boyerd/sprocket_clock/README.md

Sprocket Clock

==============

A gear clock build from a driven spur gear and a large inner gear that rides on it.  The spur gear indicates minutes and the large inner gear indicates the hour.
