boyerd/sprocket_clock/hardware/sprocket_clock.pdf

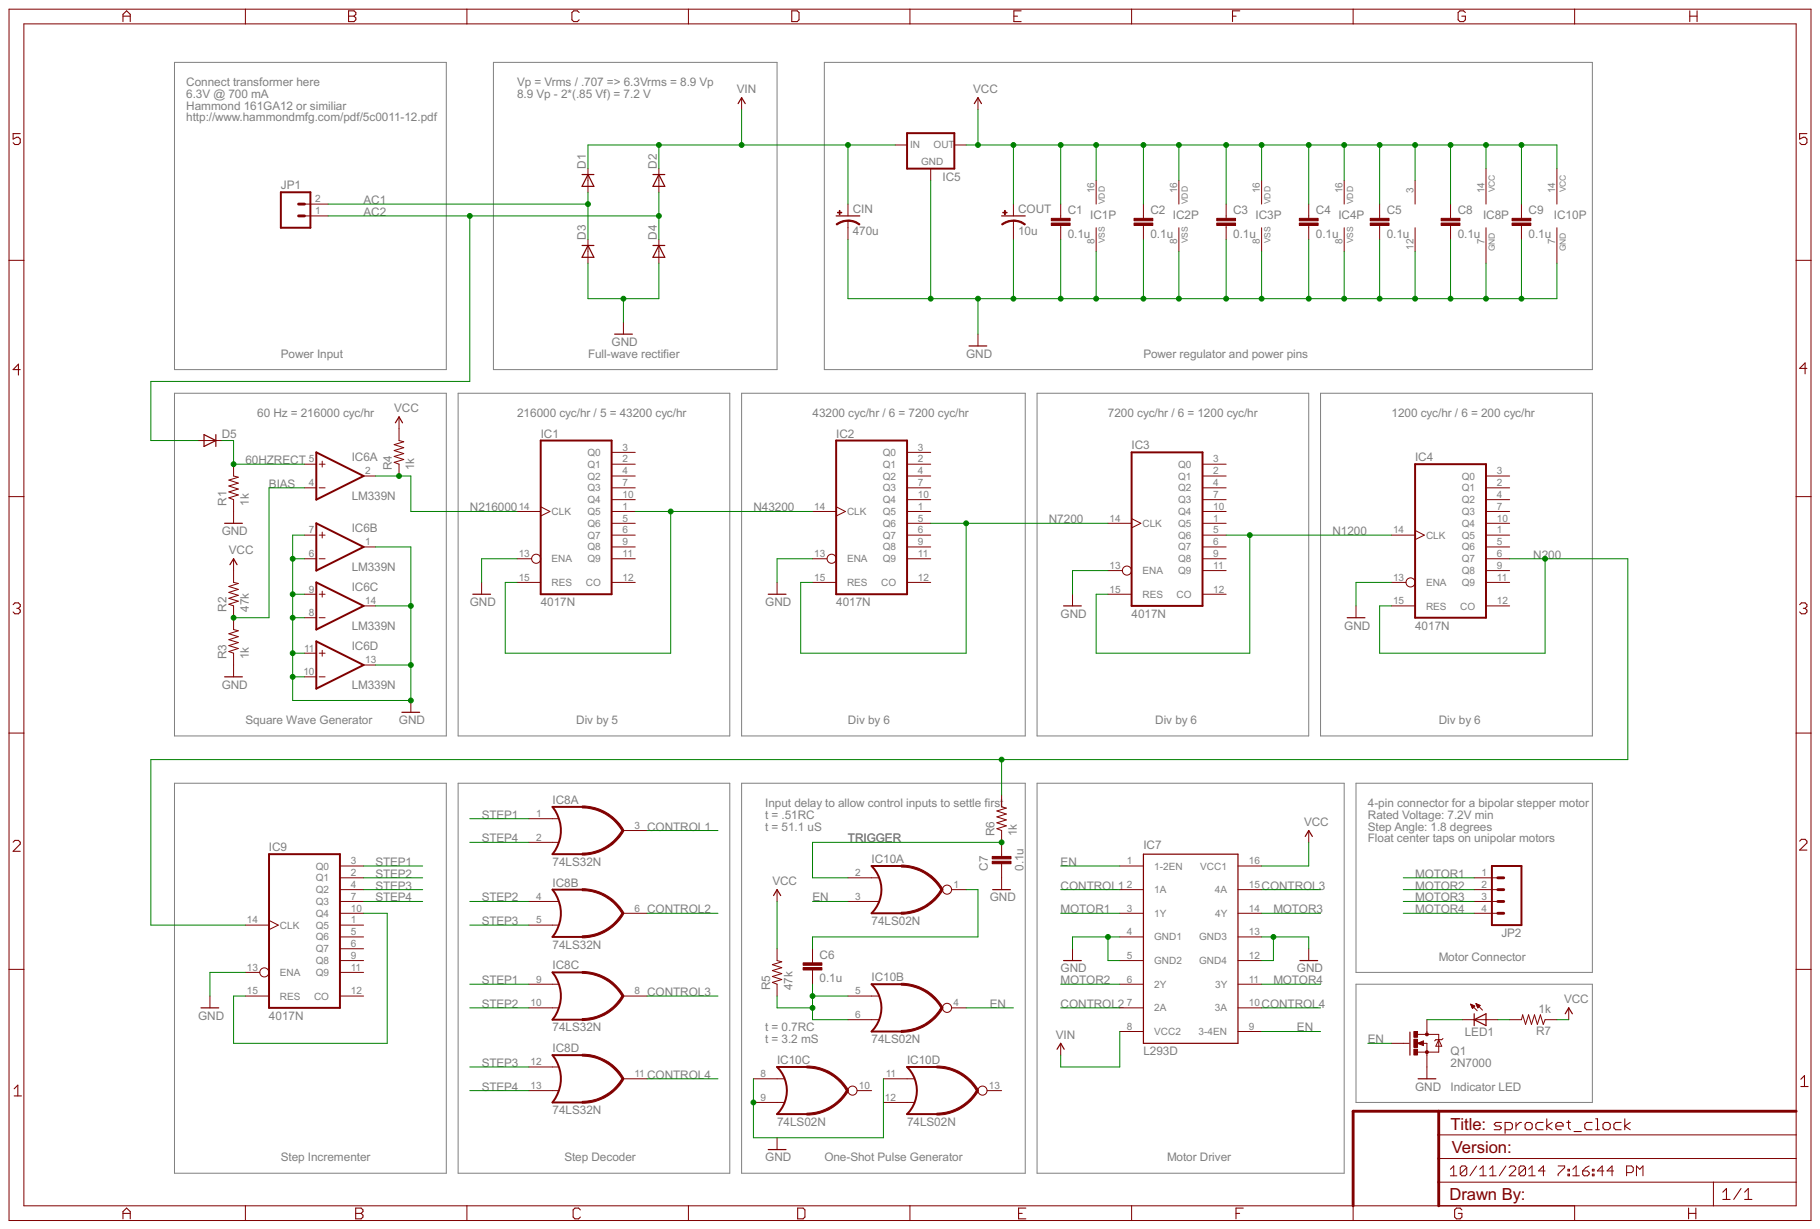
[picture p1: page 1]

http://www.hammondmfg.com/pdf/5c0011-12.pdf Connect transformer here

Input delay to allow control inputs to settle first

4-pin connector for a bipolar stepper motor Step Angle: 1.8 degrees Float center taps on unipolar motors Rated Voltage: 7.2V min

Drawn By: Title: Version:
