boyerd/sprocket_clock/hardware/sprocket_clock.brd

## EAGLE design hardware/sprocket_clock.brd (2014-10-12)

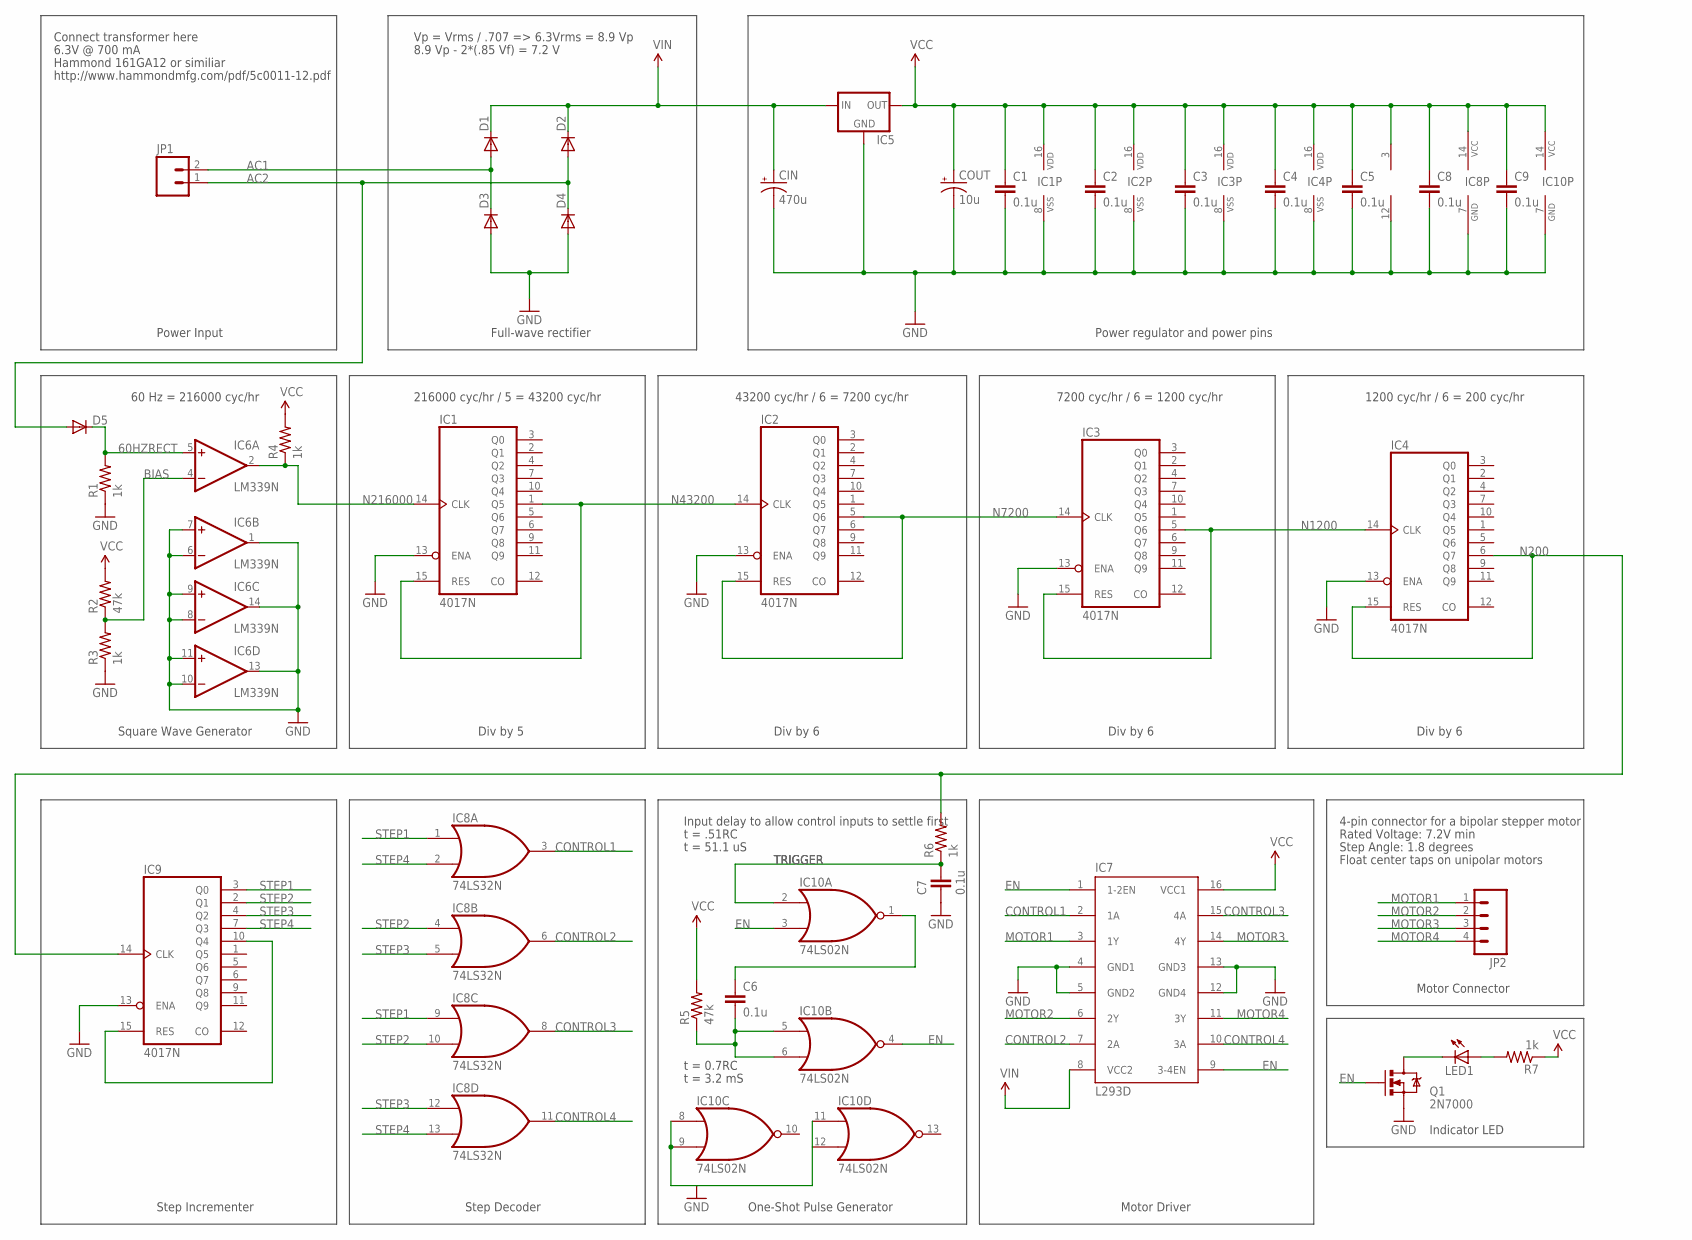
[picture p2: schematic sprocket_clock.sch]

Parts:
C1, C2, C3, C4, C5, C6, C7, C8, C9: 0.1u; CAP-PTH-5MM
CIN: 470u; CPOL-RADIAL-1000UF-63V
COUT: 10u; CPOL-RADIAL-10UF-25V
D1, D2, D3, D4, D5: DIODEPTH; DIODE-1N4001
IC1, IC2, IC3, IC4, IC9: 4017N; DIL16
IC5: V_REG_78XXTO-92; TO-92
IC6: LM339N; DIL14
IC7: L293D; DIL16
IC8: 74LS32N; DIL14
IC10: 74LS02N; DIL14
JP1: M023.5MM-NO_SILK; SCREWTERMINAL-3.5MM-2-NS
JP2: M04SCREW; SCREWTERMINAL-3.5MM-4
LED1: LED5MM
Q1: 2N7000; TO-92
R1, R3, R4, R6, R7: 1k; AXIAL-0.4
R2, R5: 47k; AXIAL-0.4

Connections:
60HZRECT: D5.C, IC6.5 (+IN), R1.P$2 (2)
AC1: D1.A, D3.C, JP1.2
AC2: D2.A, D4.C, D5.A, JP1.1
BIAS: IC6.4 (-IN), R2.P$1 (1), R3.P$2 (2)
CONTROL1: IC7.2 (1A), IC8.3 (O)
CONTROL2: IC7.7 (2A), IC8.6 (O)
CONTROL3: IC7.15 (4A), IC8.8 (O)
CONTROL4: IC7.10 (3A), IC8.11 (O)
EN: IC7.1 (1-2EN), IC7.9 (3-4EN), IC10.3 (I1), IC10.4 (O), Q1.2 (G)
GND: C1.2, C2.2, C3.2, C4.2, C5.2, C7.2, C8.2, C9.2, CIN.2 (-), COUT.2 (-), D3.A, D4.A, IC1.8 (VSS), IC1.13 (ENA), IC2.8 (VSS), IC3.8 (VSS), IC4.8 (VSS), IC5.1 (GND), IC6.1 (OUT), IC6.6 (-IN), IC6.7 (+IN), IC6.8 (-IN), IC6.9 (+IN), IC6.10 (-IN), IC6.11 (+IN), IC6.12 (GND), IC6.13 (OUT), IC6.14 (OUT), IC7.4 (GND1), IC7.5 (GND2), IC7.12 (GND4), IC7.13 (GND3), IC8.7 (GND), IC10.7 (GND), Q1.1 (S), R1.P$1 (1), R3.P$1 (1)
MOTOR1: IC7.3 (1Y), JP2.1
MOTOR2: IC7.6 (2Y), JP2.2
MOTOR3: IC7.14 (4Y), JP2.3
MOTOR4: IC7.11 (3Y), JP2.4
N200: IC4.6 (Q7), IC4.15 (RES), IC9.14 (CLK), R6.P$2 (2)
N1200: IC3.5 (Q6), IC3.15 (RES), IC4.14 (CLK)
N7200: IC2.5 (Q6), IC2.15 (RES), IC3.14 (CLK)
N43200: IC1.1 (Q5), IC1.15 (RES), IC2.14 (CLK)
N216000: IC1.14 (CLK), IC6.2 (OUT), R4.P$1 (1)
unnamed: LED1.A, R7.P$2 (2)
unnamed: IC9.10 (Q4), IC9.15 (RES)
unnamed: C6.1, IC10.1 (O)
unnamed: C6.2, IC10.5 (I0), IC10.6 (I1), R5.P$1 (1)
unnamed: LED1.K (C), Q1.3 (D)
unnamed: IC10.8 (I0), IC10.9 (I1), IC10.11 (I0)
STEP1: IC8.1 (I0), IC8.9 (I0), IC9.3 (Q0)
STEP2: IC8.4 (I0), IC8.10 (I1), IC9.2 (Q1)
STEP3: IC8.5 (I1), IC8.12 (I0), IC9.4 (Q2)
STEP4: IC8.2 (I1), IC8.13 (I1), IC9.7 (Q3)
TRIGGER: C7.1, IC10.2 (I0), R6.P$1 (1)
VCC: C1.1, C2.1, C3.1, C4.1, C5.1, C8.1, COUT.1 (+), IC1.16 (VDD), IC2.16 (VDD), IC3.16 (VDD), IC4.16 (VDD), IC5.3 (OUT), IC6.3 (V+), IC7.16 (VCC1), IC8.14 (VCC), IC10.14 (VCC), R2.P$2 (2), R4.P$2 (2), R5.P$2 (2), R7.P$1 (1)
VDD: IC9.16 (VDD)
VIN: CIN.1 (+), D1.C, D2.C, IC5.2 (IN), IC7.8 (VCC2)
VSS: IC9.8 (VSS)

Notes on the sheet:
Div by 5
Div by 6
http://www.hammondmfg.com/pdf/5c0011-12.pdf
Connect transformer here
6.3V @ 700 mA
Hammond 161GA12 or similiar
Vp = Vrms / .707 => 6.3Vrms = 8.9 Vp
8.9 Vp - 2*(.85 Vf) = 7.2 V
Power Input
Full-wave rectifier
Power regulator and power pins
Square Wave Generator
60 Hz = 216000 cyc/hr
216000 cyc/hr / 5 = 43200 cyc/hr
43200 cyc/hr / 6 = 7200 cyc/hr
7200 cyc/hr / 6 = 1200 cyc/hr
1200 cyc/hr / 6 = 200 cyc/hr
Step Incrementer
Step Decoder
One-Shot Pulse Generator
Motor Driver
Motor Connector
4-pin connector for a bipolar stepper motor
Step Angle: 1.8 degrees
Float center taps on unipolar motors
Rated Voltage: 7.2V min
t = 0.7RC
t = .51RC
t = 51.1 uS
Input delay to allow control inputs to settle first
Indicator LED
t = 3.2 mS

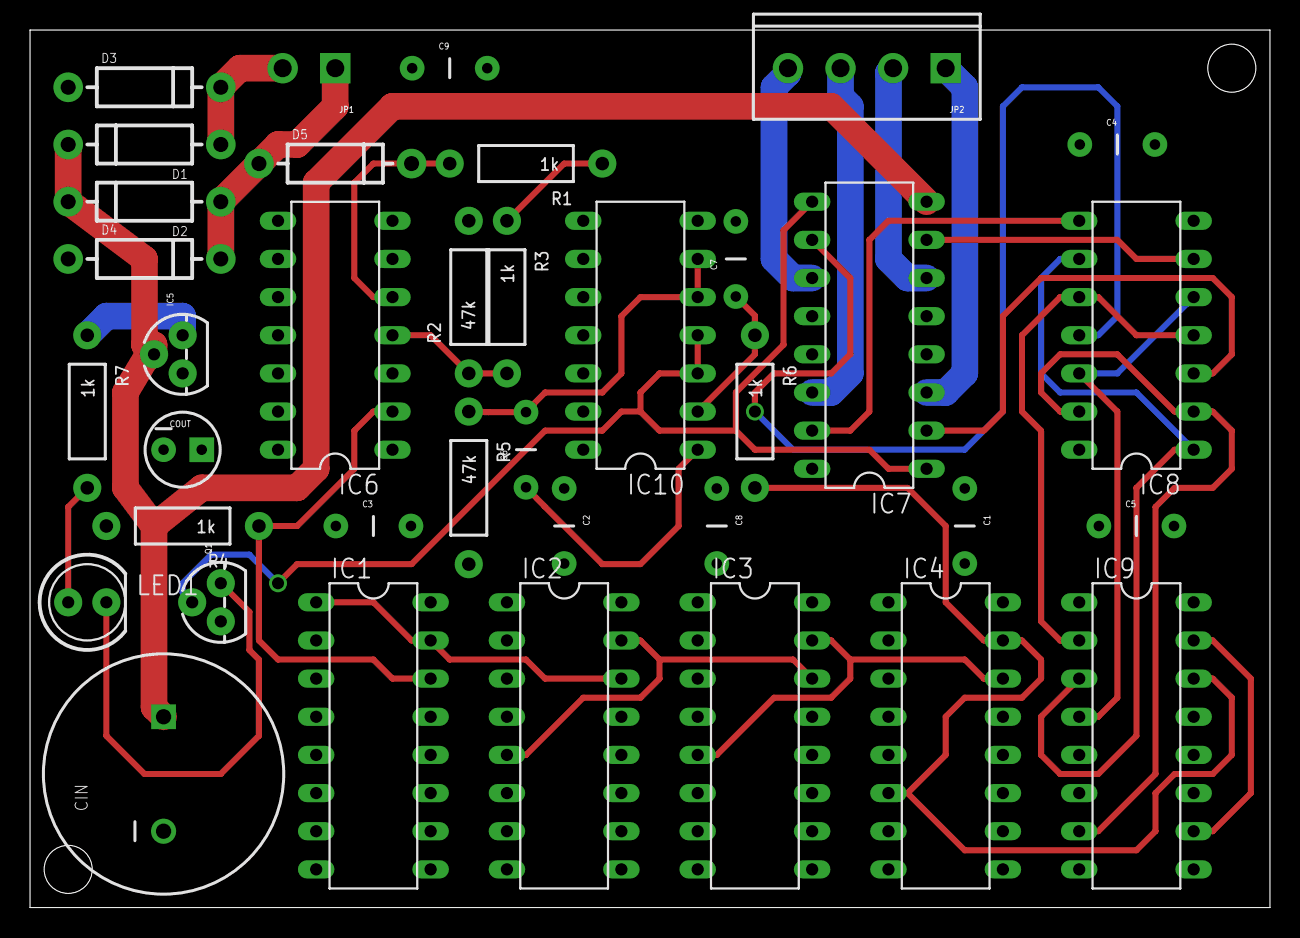
[picture p3: board sprocket_clock.brd from above]

Board: 2 copper layers, 82.5 x 58.4 mm, 37 parts (0 on the bottom side), 32 nets.
